NinjaGirlGmr/bluebot/3d_stl/README.md

# 3D STL Parts

This directory contains the robot's printable 3D part models (`.stl`).

## Files

- `Buck Mount.stl`
- `Camera deck.stl`
- `Camera Mount.stl`
- `Compute deck.stl`
- `IMU Box.stl`
- `Lidar Deck.stl`
- `Motor Deck.stl`
- `Power Switch Housing & Charge Port.stl`
- `Stand-offs.stl`
- `WIFI Mount.stl`

## Notes

- Open these files in your slicer/CAD tool to inspect orientation and scaling before printing.
- Keep part filenames stable to avoid breaking references in documentation and build notes.
