NinjaGirlGmr/bluebot/src/isaac_ros_occupancy_grid_localizer/maps/isaac_sim.png

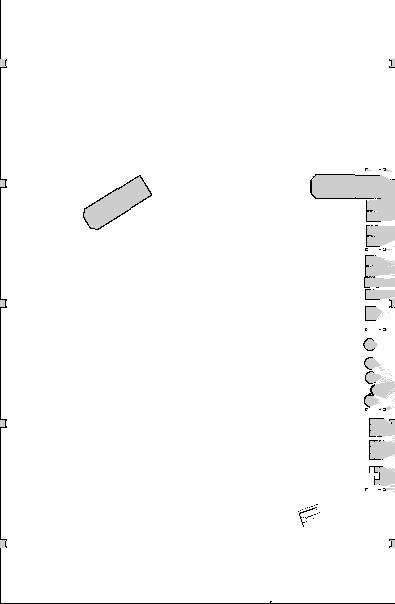
src/isaac_ros_occupancy_grid_localizer/maps/isaac_sim.png
