NinjaGirlGmr/bluebot/src/isaac_ros_occupancy_grid_localizer/maps/map.png

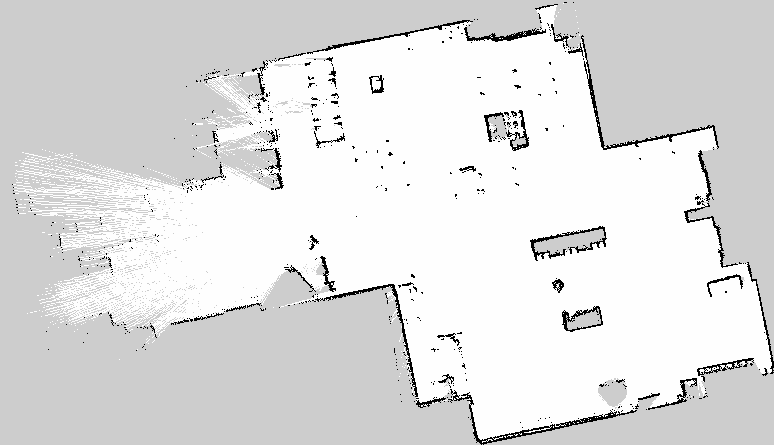
src/isaac_ros_occupancy_grid_localizer/maps/map.png
