NinjaGirlGmr/bluebot/3d_stl/Buck Mount.stl

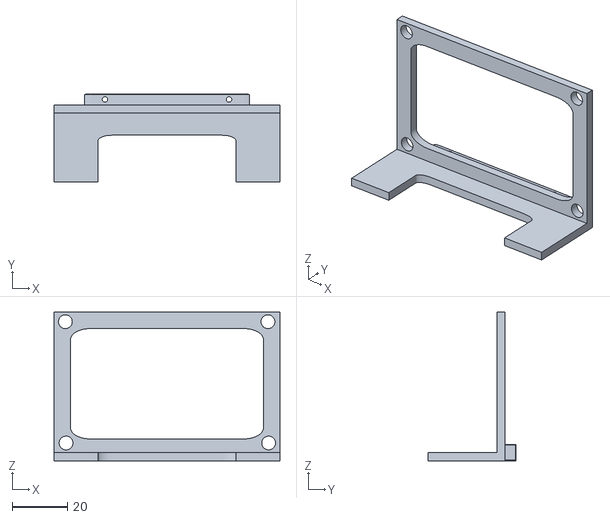
[picture p3: CAD file, 2026-03-10]
3d_stl/Buck Mount.stl
82.0 x 32.0 x 54.0
