NinjaGirlGmr/bluebot/3d_stl/Lidar Deck.stl

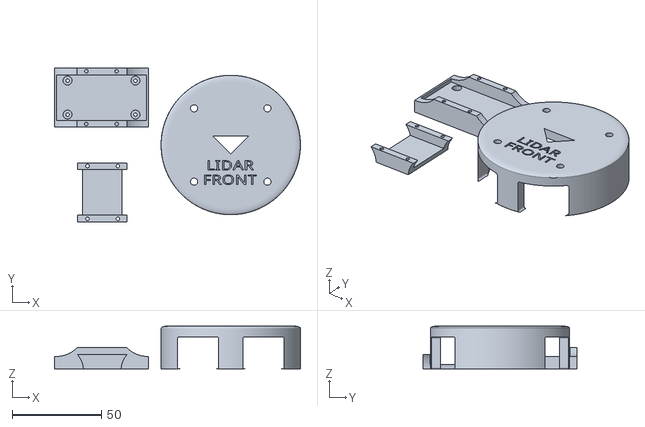
[picture p4: CAD file, 2026-03-10]
3d_stl/Lidar Deck.stl
137.6 x 86.0 x 24.0
