NinjaGirlGmr/bluebot/3d_stl/Camera Mount.stl

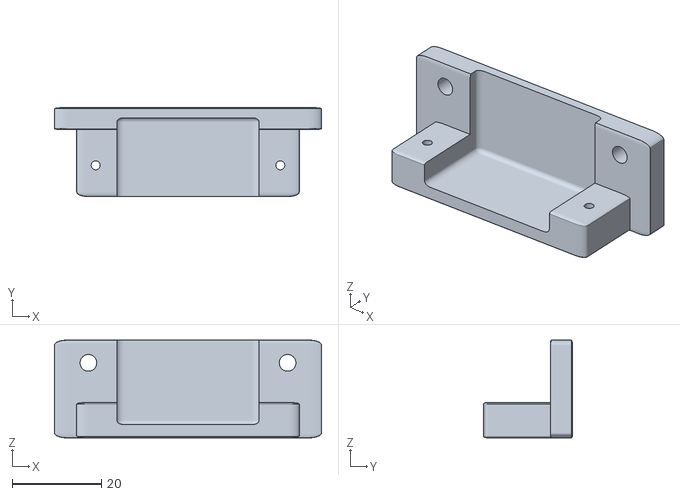
[picture p5: CAD file, 2026-03-10]
3d_stl/Camera Mount.stl
60.0 x 20.0 x 22.0
