NinjaGirlGmr/bluebot/3d_stl/Camera deck.stl

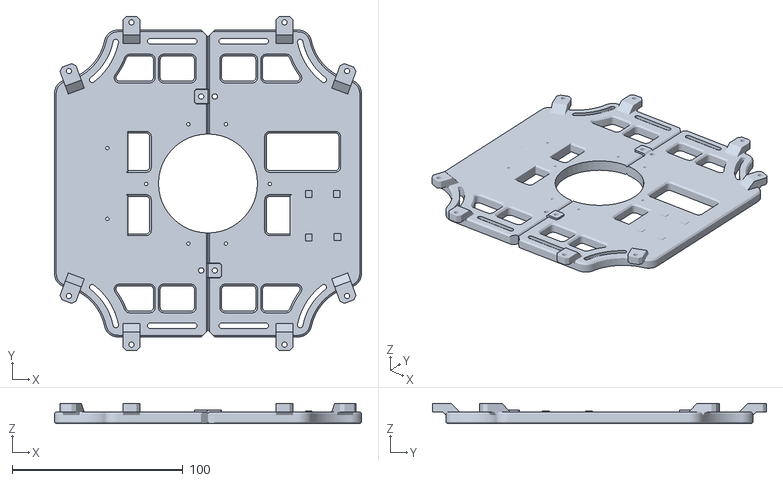
[picture p6: CAD file, 2026-03-10]
3d_stl/Camera deck.stl
180.0 x 196.0 x 12.0
