NinjaGirlGmr/bluebot/3d_stl/Stand-offs.stl

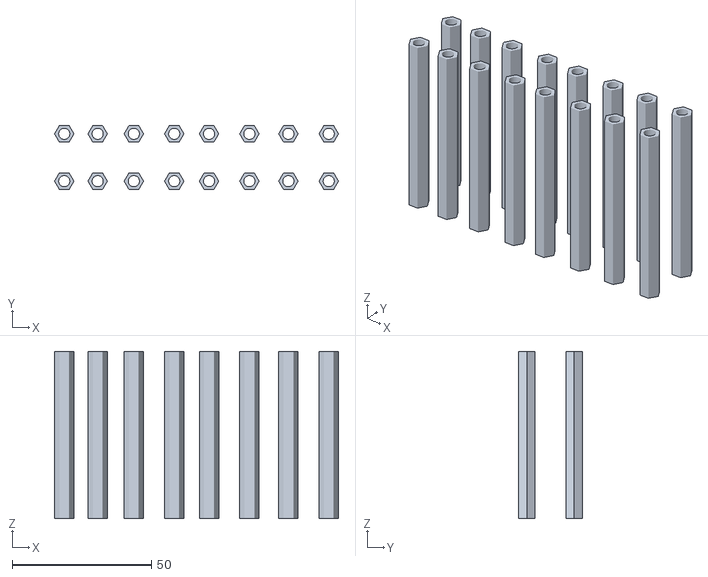
[picture p7: CAD file, 2026-03-10]
3d_stl/Stand-offs.stl
102.0 x 23.0 x 60.0
