NinjaGirlGmr/bluebot/3d_stl/Motor Deck.stl

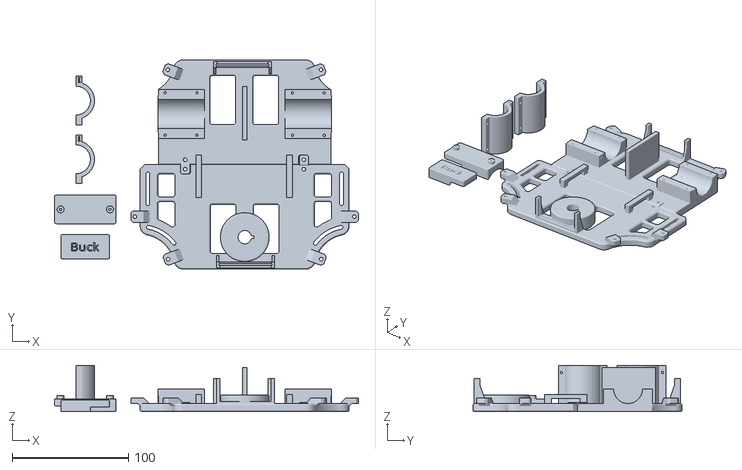
[picture p8: CAD file, 2026-03-10]
3d_stl/Motor Deck.stl
261.7 x 180.0 x 40.0
