NinjaGirlGmr/bluebot/3d_stl/Compute deck.stl

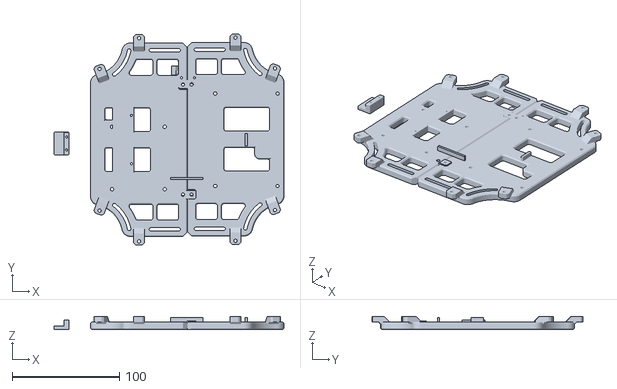
[picture p9: CAD file, 2026-03-10]
3d_stl/Compute deck.stl
214.0 x 196.5 x 12.0
