NinjaGirlGmr/bluebot/3d_stl/IMU Box.stl

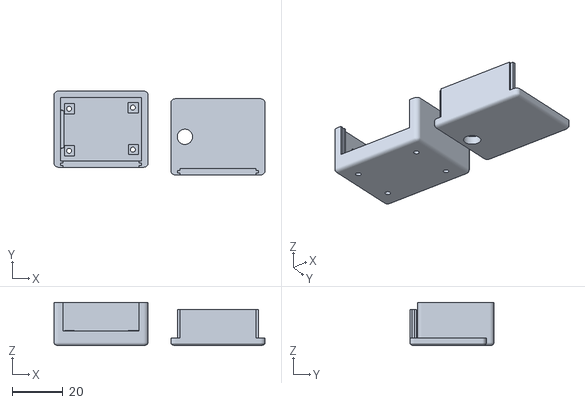
[picture p10: CAD file, 2026-03-10]
3d_stl/IMU Box.stl
83.0 x 33.0 x 17.0
