NinjaGirlGmr/bluebot/3d_stl/WIFI Mount.stl

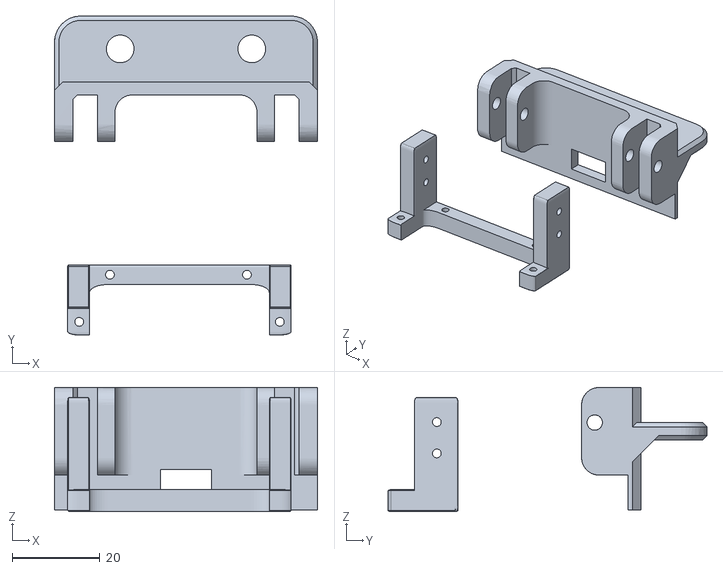
[picture p11: CAD file, 2026-03-10]
3d_stl/WIFI Mount.stl
60.0 x 72.8 x 28.3
