NinjaGirlGmr/bluebot/3d_stl/Power Switch Housing & Charge Port.stl

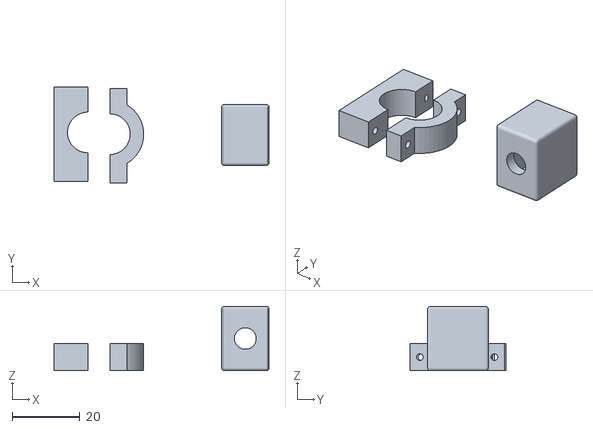
[picture p12: CAD file, 2026-03-10]
3d_stl/Power Switch Housing & Charge Port.stl
63.5 x 28.5 x 19.0
