NinjaGirlGmr/bluebot/src/robot_bringup/config/state_estimation_drift.yaml

robot_localization_filter:
  ros__parameters:
    use_sim_time: false
    frequency: 30.0
    sensor_timeout: 0.2
    two_d_mode: true
    debug: false
    publish_tf: true
    print_diagnostics: false
    use_control: false
    predict_to_current_time: true
    reset_on_time_jump: true
    transform_time_offset: 0.0
    transform_timeout: 0.0

    map_frame: map
    odom_frame: odom
    base_link_frame: base_link
    world_frame: odom

    # Primary pose source: wheel odometry.
    odom0: /odom_raw
    odom0_queue_size: 10
    odom0_differential: false
    odom0_relative: false
    odom0_config: [
      true, true, false,
      false, false, true,
      true, false, false,
      false, false, true,
      false, false, false
    ]

    # Keep imu0 channel wired but disabled by default.
    imu0: /imu/orientation
    imu0_queue_size: 10
    imu0_differential: false
    imu0_relative: false
    imu0_remove_gravitational_acceleration: false
    imu0_config: [
      false, false, false,
      false, false, false,
      false, false, false,
      false, false, false,
      false, false, false
    ]

    # Odom drift mitigation: use IMU yaw-rate only.
    imu1: /imu/data_raw
    imu1_queue_size: 10
    imu1_differential: false
    imu1_relative: false
    imu1_remove_gravitational_acceleration: true
    imu1_config: [
      false, false, false,
      false, false, false,
      false, false, false,
      false, false, true,
      false, false, false
    ]
