NinjaGirlGmr/bluebot/src/robot_bringup/robot_bringup/apriltag_map_recorder_node.py

#!/usr/bin/env python3

from dataclasses import dataclass
from pathlib import Path
import math
import re
from typing import Dict, Tuple

from geometry_msgs.msg import Pose, PoseArray, TransformStamped
from nav_msgs.msg import Odometry
import rclpy
from isaac_ros_apriltag_interfaces.msg import AprilTagDetectionArray
from rclpy.duration import Duration
from rclpy.executors import ExternalShutdownException
from rclpy.node import Node
from rclpy.qos import qos_profile_sensor_data
from rclpy.time import Time
from tf2_ros import Buffer, TransformBroadcaster, TransformException, TransformListener
import yaml


QuaternionTuple = Tuple[float, float, float, float]
Vector3Tuple = Tuple[float, float, float]


@dataclass
class TagAggregate:
    family: str
    tag_id: int
    observations: int = 0
    sum_x: float = 0.0
    sum_y: float = 0.0
    sum_z: float = 0.0
    sum_qx: float = 0.0
    sum_qy: float = 0.0
    sum_qz: float = 0.0
    sum_qw: float = 0.0
    latest_qx: float = 0.0
    latest_qy: float = 0.0
    latest_qz: float = 0.0
    latest_qw: float = 1.0
    first_seen_sec: float = 0.0
    last_seen_sec: float = 0.0
    last_sample_time_ns: int = 0


@dataclass
class TagTrackState:
    consecutive_count: int = 0
    last_seen_time_ns: int = 0


@dataclass
class TagLandmark:
    family: str
    tag_id: int
    observations: int
    first_seen_sec: float
    last_seen_sec: float
    x: float
    y: float
    z: float
    qx: float
    qy: float
    qz: float
    qw: float


class AprilTagMapRecorderNode(Node):
    def __init__(self) -> None:
        super().__init__('apriltag_map_recorder')

        self.declare_parameter('detections_topic', '/tag_detections')
        self.declare_parameter('odom_topic', '/odom')
        self.declare_parameter('map_frame', 'map')
        self.declare_parameter('output_yaml', '/tmp/apriltag_map_landmarks.yaml')
        self.declare_parameter('write_period_sec', 5.0)
        self.declare_parameter('min_observations', 1)
        self.declare_parameter('min_consecutive_detections', 10)
        self.declare_parameter('max_consecutive_gap_sec', 0.30)
        self.declare_parameter('min_sample_interval_sec', 0.10)
        self.declare_parameter('require_stationary', True)
        self.declare_parameter('max_robot_linear_speed_mps', 0.03)
        self.declare_parameter('max_robot_angular_speed_rad_s', 0.10)
        self.declare_parameter('min_detection_range_m', 0.10)
        self.declare_parameter('max_detection_range_m', 2.50)
        self.declare_parameter('use_covariance_filter', True)
        self.declare_parameter('allow_zero_covariance', True)
        self.declare_parameter('max_detection_position_stddev_m', 0.20)
        self.declare_parameter('max_detection_yaw_stddev_rad', 0.35)
        self.declare_parameter('use_latest_tf_on_failure', True)
        self.declare_parameter('write_on_shutdown', True)
        self.declare_parameter('log_new_tags', True)
        self.declare_parameter('log_rejections', False)
        self.declare_parameter('publish_landmarks_topic', True)
        self.declare_parameter('landmarks_topic', '/apriltag/landmarks')
        self.declare_parameter('publish_landmark_tf', True)
        self.declare_parameter('landmark_tf_child_frame_prefix', 'apriltag_landmark')
        self.declare_parameter('landmark_publish_period_sec', 0.50)

        self._detections_topic = str(self.get_parameter('detections_topic').value)
        self._odom_topic = str(self.get_parameter('odom_topic').value)
        self._map_frame = str(self.get_parameter('map_frame').value)
        self._output_yaml = str(self.get_parameter('output_yaml').value)
        self._write_period_sec = float(self.get_parameter('write_period_sec').value)
        self._min_observations = int(self.get_parameter('min_observations').value)
        self._min_consecutive_detections = int(
            self.get_parameter('min_consecutive_detections').value
        )
        self._max_consecutive_gap_sec = float(
            self.get_parameter('max_consecutive_gap_sec').value
        )
        self._min_sample_interval_sec = float(
            self.get_parameter('min_sample_interval_sec').value
        )
        self._require_stationary = bool(self.get_parameter('require_stationary').value)
        self._max_robot_linear_speed_mps = float(
            self.get_parameter('max_robot_linear_speed_mps').value
        )
        self._max_robot_angular_speed_rad_s = float(
            self.get_parameter('max_robot_angular_speed_rad_s').value
        )
        self._min_detection_range_m = float(self.get_parameter('min_detection_range_m').value)
        self._max_detection_range_m = float(self.get_parameter('max_detection_range_m').value)
        self._use_covariance_filter = bool(self.get_parameter('use_covariance_filter').value)
        self._allow_zero_covariance = bool(self.get_parameter('allow_zero_covariance').value)
        self._max_detection_position_stddev_m = float(
            self.get_parameter('max_detection_position_stddev_m').value
        )
        self._max_detection_yaw_stddev_rad = float(
            self.get_parameter('max_detection_yaw_stddev_rad').value
        )
        self._use_latest_tf_on_failure = bool(
            self.get_parameter('use_latest_tf_on_failure').value
        )
        self._write_on_shutdown = bool(self.get_parameter('write_on_shutdown').value)
        self._log_new_tags = bool(self.get_parameter('log_new_tags').value)
        self._log_rejections = bool(self.get_parameter('log_rejections').value)
        self._publish_landmarks_topic = bool(
            self.get_parameter('publish_landmarks_topic').value
        )
        self._landmarks_topic = str(self.get_parameter('landmarks_topic').value)
        self._publish_landmark_tf = bool(self.get_parameter('publish_landmark_tf').value)
        self._landmark_tf_child_frame_prefix = str(
            self.get_parameter('landmark_tf_child_frame_prefix').value
        ).strip('/')
        self._landmark_publish_period_sec = float(
            self.get_parameter('landmark_publish_period_sec').value
        )

        if self._write_period_sec <= 0.0:
            self._write_period_sec = 5.0
        if self._min_observations < 1:
            self._min_observations = 1
        if self._min_consecutive_detections < 1:
            self._min_consecutive_detections = 1
        if self._max_consecutive_gap_sec <= 0.0:
            self._max_consecutive_gap_sec = 0.30
        if self._min_sample_interval_sec < 0.0:
            self._min_sample_interval_sec = 0.0
        if self._max_robot_linear_speed_mps < 0.0:
            self._max_robot_linear_speed_mps = 0.0
        if self._max_robot_angular_speed_rad_s < 0.0:
            self._max_robot_angular_speed_rad_s = 0.0
        if self._min_detection_range_m < 0.0:
            self._min_detection_range_m = 0.0
        if self._max_detection_range_m < self._min_detection_range_m:
            self._max_detection_range_m = self._min_detection_range_m
        if self._max_detection_position_stddev_m <= 0.0:
            self._max_detection_position_stddev_m = 0.20
        if self._max_detection_yaw_stddev_rad <= 0.0:
            self._max_detection_yaw_stddev_rad = 0.35
        if self._landmark_publish_period_sec <= 0.0:
            self._landmark_publish_period_sec = 0.50

        self._tag_data: Dict[str, TagAggregate] = {}
        self._tag_track: Dict[str, TagTrackState] = {}
        self._dirty = False
        self._last_warn_ns: Dict[str, int] = {}
        self._have_odom = False
        self._last_linear_speed_mps = 0.0
        self._last_angular_speed_rad_s = 0.0

        self._max_consecutive_gap_ns = int(self._max_consecutive_gap_sec * 1.0e9)
        self._min_sample_interval_ns = int(self._min_sample_interval_sec * 1.0e9)

        self._tf_buffer = Buffer(cache_time=Duration(seconds=30.0))
        self._tf_listener = TransformListener(self._tf_buffer, self)
        self._landmarks_pub = None
        if self._publish_landmarks_topic:
            self._landmarks_pub = self.create_publisher(PoseArray, self._landmarks_topic, 10)
        self._landmark_tf_broadcaster = (
            TransformBroadcaster(self) if self._publish_landmark_tf else None
        )

        self.create_subscription(
            Odometry,
            self._odom_topic,
            self._on_odom,
            qos_profile_sensor_data,
        )
        self.create_subscription(
            AprilTagDetectionArray,
            self._detections_topic,
            self._on_detections,
            qos_profile_sensor_data,
        )
        self.create_timer(self._write_period_sec, self._on_write_timer)
        if self._landmarks_pub is not None or self._landmark_tf_broadcaster is not None:
            self.create_timer(
                self._landmark_publish_period_sec,
                self._on_landmarks_publish_timer,
            )

        self.get_logger().info(
            'AprilTag map recorder started. '
            f'detections_topic={self._detections_topic}, map_frame={self._map_frame}, '
            f'output_yaml={self._output_yaml}, require_stationary={self._require_stationary}, '
            f'min_consecutive={self._min_consecutive_detections}, '
            f'publish_landmarks_topic={self._publish_landmarks_topic}, '
            f'publish_landmark_tf={self._publish_landmark_tf}'
        )

    def _on_odom(self, msg: Odometry) -> None:
        twist = msg.twist.twist
        self._last_linear_speed_mps = math.sqrt(
            (twist.linear.x * twist.linear.x)
            + (twist.linear.y * twist.linear.y)
            + (twist.linear.z * twist.linear.z)
        )
        self._last_angular_speed_rad_s = abs(float(twist.angular.z))
        self._have_odom = True

    def _on_detections(self, msg: AprilTagDetectionArray) -> None:
        for detection in msg.detections:
            family = detection.family if detection.family else 'unknown'
            tag_id = int(detection.id)
            key = f'{family}:{tag_id}'

            source_frame = detection.pose.header.frame_id or msg.header.frame_id
            if not source_frame:
                self._warn_throttled(
                    'missing_source_frame',
                    'Skipping detection with empty source frame_id.',
                )
                continue

            pose_stamp = detection.pose.header.stamp
            if self._is_zero_stamp(pose_stamp):
                pose_stamp = msg.header.stamp
            stamp_time = self._stamp_to_time(pose_stamp)
            source_pose = detection.pose.pose.pose
            now_ns = (
                int(stamp_time.nanoseconds)
                if int(stamp_time.nanoseconds) != 0
                else self.get_clock().now().nanoseconds
            )

            detection_range_m = math.sqrt(
                (source_pose.position.x * source_pose.position.x)
                + (source_pose.position.y * source_pose.position.y)
                + (source_pose.position.z * source_pose.position.z)
            )
            if (
                detection_range_m < self._min_detection_range_m
                or detection_range_m > self._max_detection_range_m
            ):
                self._log_rejection(
                    key,
                    (
                        f'range gate failed ({detection_range_m:.2f}m outside '
                        f'[{self._min_detection_range_m:.2f}, {self._max_detection_range_m:.2f}]m)'
                    ),
                )
                self._update_track_state(key, now_ns)
                continue

            if self._use_covariance_filter and not self._covariance_ok(
                detection.pose.pose.covariance,
                key,
            ):
                self._update_track_state(key, now_ns)
                continue

            track_state = self._update_track_state(key, now_ns)
            if track_state.consecutive_count < self._min_consecutive_detections:
                continue

            if not self._is_stationary():
                self._log_rejection(
                    key,
                    (
                        f'robot moving (lin={self._last_linear_speed_mps:.3f} m/s, '
                        f'ang={self._last_angular_speed_rad_s:.3f} rad/s)'
                    ),
                )
                continue

            aggregate = self._tag_data.get(key)
            if aggregate is None:
                aggregate = TagAggregate(
                    family=family,
                    tag_id=tag_id,
                    first_seen_sec=self._now_sec(),
                )
                self._tag_data[key] = aggregate
                if self._log_new_tags:
                    self.get_logger().info(
                        f'New tag observed: family={aggregate.family}, id={aggregate.tag_id}'
                    )

            if (
                aggregate.last_sample_time_ns > 0
                and now_ns < aggregate.last_sample_time_ns + self._min_sample_interval_ns
            ):
                continue

            transformed = self._transform_pose_to_map(
                source_frame=source_frame,
                stamp_time=stamp_time,
                position=(
                    float(source_pose.position.x),
                    float(source_pose.position.y),
                    float(source_pose.position.z),
                ),
                orientation=(
                    float(source_pose.orientation.x),
                    float(source_pose.orientation.y),
                    float(source_pose.orientation.z),
                    float(source_pose.orientation.w),
                ),
            )

            if transformed is None:
                continue

            pos_map, quat_map = transformed
            now_sec = self._now_sec()
            quat_map = self._quat_normalize(quat_map)
            if aggregate.observations > 0:
                dot = self._quat_dot(
                    quat_map,
                    (
                        aggregate.sum_qx,
                        aggregate.sum_qy,
                        aggregate.sum_qz,
                        aggregate.sum_qw,
                    ),
                )
                if dot < 0.0:
                    quat_map = (-quat_map[0], -quat_map[1], -quat_map[2], -quat_map[3])

            aggregate.observations += 1
            aggregate.sum_x += pos_map[0]
            aggregate.sum_y += pos_map[1]
            aggregate.sum_z += pos_map[2]
            aggregate.sum_qx += quat_map[0]
            aggregate.sum_qy += quat_map[1]
            aggregate.sum_qz += quat_map[2]
            aggregate.sum_qw += quat_map[3]
            aggregate.latest_qx = quat_map[0]
            aggregate.latest_qy = quat_map[1]
            aggregate.latest_qz = quat_map[2]
            aggregate.latest_qw = quat_map[3]
            aggregate.last_seen_sec = now_sec
            aggregate.last_sample_time_ns = now_ns

            if aggregate.first_seen_sec <= 0.0:
                aggregate.first_seen_sec = now_sec

            self._dirty = True

    def _transform_pose_to_map(
        self,
        source_frame: str,
        stamp_time: Time,
        position: Vector3Tuple,
        orientation: QuaternionTuple,
    ) -> Tuple[Vector3Tuple, QuaternionTuple] | None:
        transform = None
        try:
            transform = self._tf_buffer.lookup_transform(
                self._map_frame,
                source_frame,
                stamp_time,
                timeout=Duration(seconds=0.05),
            )
        except TransformException as exc:
            if self._use_latest_tf_on_failure:
                try:
                    transform = self._tf_buffer.lookup_transform(
                        self._map_frame,
                        source_frame,
                        Time(),
                        timeout=Duration(seconds=0.05),
                    )
                except TransformException:
                    self._warn_throttled(
                        f'tf_lookup_latest_{source_frame}',
                        f'Failed transform {source_frame}->{self._map_frame}: {exc}',
                    )
                    return None
            else:
                self._warn_throttled(
                    f'tf_lookup_{source_frame}',
                    f'Failed transform {source_frame}->{self._map_frame}: {exc}',
                )
                return None

        tf_t = transform.transform.translation
        tf_q = transform.transform.rotation
        tf_translation: Vector3Tuple = (float(tf_t.x), float(tf_t.y), float(tf_t.z))
        tf_quaternion: QuaternionTuple = (
            float(tf_q.x),
            float(tf_q.y),
            float(tf_q.z),
            float(tf_q.w),
        )

        rotated_position = self._quat_rotate_vector(tf_quaternion, position)
        position_out: Vector3Tuple = (
            rotated_position[0] + tf_translation[0],
            rotated_position[1] + tf_translation[1],
            rotated_position[2] + tf_translation[2],
        )
        orientation_out = self._quat_normalize(
            self._quat_multiply(tf_quaternion, orientation)
        )
        return (position_out, orientation_out)

    def _on_write_timer(self) -> None:
        self.write_yaml_snapshot(force=False)

    def _on_landmarks_publish_timer(self) -> None:
        self._publish_registered_landmarks()

    def write_yaml_snapshot(self, force: bool) -> None:
        if not force and not self._dirty:
            return

        output_path = Path(self._output_yaml).expanduser()
        output_path.parent.mkdir(parents=True, exist_ok=True)

        landmarks = self._build_registered_landmarks()
        tags = []
        for item in landmarks:
            tags.append({
                'family': item.family,
                'id': item.tag_id,
                'observations': item.observations,
                'first_seen_sec': round(item.first_seen_sec, 6),
                'last_seen_sec': round(item.last_seen_sec, 6),
                'position': {
                    'x': round(item.x, 6),
                    'y': round(item.y, 6),
                    'z': round(item.z, 6),
                },
                'orientation': {
                    'x': round(item.qx, 6),
                    'y': round(item.qy, 6),
                    'z': round(item.qz, 6),
                    'w': round(item.qw, 6),
                },
            })

        payload = {
            'map_frame': self._map_frame,
            'generated_at_sec': round(self._now_sec(), 6),
            'detections_topic': self._detections_topic,
            'odom_topic': self._odom_topic,
            'min_observations': self._min_observations,
            'min_consecutive_detections': self._min_consecutive_detections,
            'require_stationary': self._require_stationary,
            'max_robot_linear_speed_mps': self._max_robot_linear_speed_mps,
            'max_robot_angular_speed_rad_s': self._max_robot_angular_speed_rad_s,
            'publish_landmarks_topic': self._publish_landmarks_topic,
            'landmarks_topic': self._landmarks_topic,
            'publish_landmark_tf': self._publish_landmark_tf,
            'landmark_tf_child_frame_prefix': self._landmark_tf_child_frame_prefix,
            'tags': tags,
        }

        try:
            with output_path.open('w', encoding='utf-8') as f:
                yaml.safe_dump(payload, f, sort_keys=False)
            self._dirty = False
            self.get_logger().info(
                f'Wrote {len(tags)} tag landmarks to {output_path}'
            )
        except OSError as exc:
            self.get_logger().error(f'Failed writing YAML to {output_path}: {exc}')

    def _sorted_tag_items(self) -> list[TagAggregate]:
        return sorted(
            self._tag_data.values(),
            key=lambda item: (item.family, item.tag_id),
        )

    def _build_registered_landmarks(self) -> list[TagLandmark]:
        landmarks: list[TagLandmark] = []
        for item in self._sorted_tag_items():
            if item.observations < self._min_observations:
                continue
            inv_count = 1.0 / float(item.observations)
            avg_q = self._quat_normalize(
                (item.sum_qx, item.sum_qy, item.sum_qz, item.sum_qw)
            )
            landmarks.append(
                TagLandmark(
                    family=item.family,
                    tag_id=item.tag_id,
                    observations=item.observations,
                    first_seen_sec=item.first_seen_sec,
                    last_seen_sec=item.last_seen_sec,
                    x=item.sum_x * inv_count,
                    y=item.sum_y * inv_count,
                    z=item.sum_z * inv_count,
                    qx=avg_q[0],
                    qy=avg_q[1],
                    qz=avg_q[2],
                    qw=avg_q[3],
                )
            )
        return landmarks

    def _publish_registered_landmarks(self) -> None:
        landmarks = self._build_registered_landmarks()
        now_msg = self.get_clock().now().to_msg()

        if self._landmarks_pub is not None:
            pose_array = PoseArray()
            pose_array.header.stamp = now_msg
            pose_array.header.frame_id = self._map_frame
            for landmark in landmarks:
                pose = Pose()
                pose.position.x = landmark.x
                pose.position.y = landmark.y
                pose.position.z = landmark.z
                pose.orientation.x = landmark.qx
                pose.orientation.y = landmark.qy
                pose.orientation.z = landmark.qz
                pose.orientation.w = landmark.qw
                pose_array.poses.append(pose)
            self._landmarks_pub.publish(pose_array)

        if self._landmark_tf_broadcaster is not None:
            tf_msgs: list[TransformStamped] = []
            for landmark in landmarks:
                tf_msg = TransformStamped()
                tf_msg.header.stamp = now_msg
                tf_msg.header.frame_id = self._map_frame
                tf_msg.child_frame_id = self._landmark_child_frame(
                    family=landmark.family,
                    tag_id=landmark.tag_id,
                )
                tf_msg.transform.translation.x = landmark.x
                tf_msg.transform.translation.y = landmark.y
                tf_msg.transform.translation.z = landmark.z
                tf_msg.transform.rotation.x = landmark.qx
                tf_msg.transform.rotation.y = landmark.qy
                tf_msg.transform.rotation.z = landmark.qz
                tf_msg.transform.rotation.w = landmark.qw
                tf_msgs.append(tf_msg)
            if tf_msgs:
                self._landmark_tf_broadcaster.sendTransform(tf_msgs)

    def _landmark_child_frame(self, family: str, tag_id: int) -> str:
        frame_suffix = self._sanitize_frame_component(f'{family}_{tag_id}')
        if not self._landmark_tf_child_frame_prefix:
            return frame_suffix
        return f'{self._landmark_tf_child_frame_prefix}/{frame_suffix}'

    @staticmethod
    def _sanitize_frame_component(raw: str) -> str:
        cleaned = re.sub(r'[^A-Za-z0-9_]+', '_', raw)
        cleaned = re.sub(r'_+', '_', cleaned).strip('_')
        return cleaned or 'tag'

    def _update_track_state(self, key: str, now_ns: int) -> TagTrackState:
        state = self._tag_track.get(key)
        if state is None:
            state = TagTrackState()
            self._tag_track[key] = state

        if state.last_seen_time_ns > 0 and now_ns <= (
            state.last_seen_time_ns + self._max_consecutive_gap_ns
        ):
            state.consecutive_count += 1
        else:
            state.consecutive_count = 1
        state.last_seen_time_ns = now_ns
        return state

    def _is_stationary(self) -> bool:
        if not self._require_stationary:
            return True
        if not self._have_odom:
            self._warn_throttled(
                'missing_odom',
                f'Waiting for odometry on "{self._odom_topic}" before recording tags.',
                period_sec=2.0,
            )
            return False
        return (
            self._last_linear_speed_mps <= self._max_robot_linear_speed_mps
            and self._last_angular_speed_rad_s <= self._max_robot_angular_speed_rad_s
        )

    def _covariance_ok(self, covariance, key: str) -> bool:
        if covariance is None or len(covariance) < 36:
            self._log_rejection(key, 'missing covariance array')
            return False

        var_x = float(covariance[0])
        var_y = float(covariance[7])
        var_yaw = float(covariance[35])

        if (
            abs(var_x) < 1.0e-12
            and abs(var_y) < 1.0e-12
            and abs(var_yaw) < 1.0e-12
        ):
            if self._allow_zero_covariance:
                return True
            self._log_rejection(key, 'zero covariance not allowed')
            return False

        if var_x < 0.0 or var_y < 0.0 or var_yaw < 0.0:
            self._log_rejection(key, 'negative covariance entries')
            return False

        pos_std = math.sqrt(max(var_x, var_y))
        yaw_std = math.sqrt(var_yaw)
        if pos_std > self._max_detection_position_stddev_m:
            self._log_rejection(
                key,
                (
                    f'position stddev too high ({pos_std:.3f}m > '
                    f'{self._max_detection_position_stddev_m:.3f}m)'
                ),
            )
            return False
        if yaw_std > self._max_detection_yaw_stddev_rad:
            self._log_rejection(
                key,
                (
                    f'yaw stddev too high ({yaw_std:.3f}rad > '
                    f'{self._max_detection_yaw_stddev_rad:.3f}rad)'
                ),
            )
            return False
        return True

    def _log_rejection(self, key: str, reason: str) -> None:
        if not self._log_rejections:
            return
        self._warn_throttled(f'reject_{key}', f'Rejected {key}: {reason}', period_sec=1.0)

    def _stamp_to_time(self, stamp_msg) -> Time:
        if self._is_zero_stamp(stamp_msg):
            return Time()
        return Time.from_msg(stamp_msg)

    @staticmethod
    def _is_zero_stamp(stamp_msg) -> bool:
        return int(stamp_msg.sec) == 0 and int(stamp_msg.nanosec) == 0

    def _now_sec(self) -> float:
        now = self.get_clock().now().nanoseconds
        return float(now) / 1.0e9

    def _warn_throttled(self, key: str, msg: str, period_sec: float = 5.0) -> None:
        now_ns = self.get_clock().now().nanoseconds
        prev_ns = self._last_warn_ns.get(key)
        if prev_ns is not None and now_ns < prev_ns + int(period_sec * 1.0e9):
            return
        self._last_warn_ns[key] = now_ns
        self.get_logger().warning(msg)

    @staticmethod
    def _quat_multiply(a: QuaternionTuple, b: QuaternionTuple) -> QuaternionTuple:
        ax, ay, az, aw = a
        bx, by, bz, bw = b
        return (
            (aw * bx) + (ax * bw) + (ay * bz) - (az * by),
            (aw * by) - (ax * bz) + (ay * bw) + (az * bx),
            (aw * bz) + (ax * by) - (ay * bx) + (az * bw),
            (aw * bw) - (ax * bx) - (ay * by) - (az * bz),
        )

    @staticmethod
    def _quat_conjugate(q: QuaternionTuple) -> QuaternionTuple:
        qx, qy, qz, qw = q
        return (-qx, -qy, -qz, qw)

    @classmethod
    def _quat_rotate_vector(cls, q: QuaternionTuple, v: Vector3Tuple) -> Vector3Tuple:
        vx, vy, vz = v
        v_quat: QuaternionTuple = (vx, vy, vz, 0.0)
        rotated = cls._quat_multiply(
            cls._quat_multiply(q, v_quat),
            cls._quat_conjugate(q),
        )
        return (rotated[0], rotated[1], rotated[2])

    @staticmethod
    def _quat_normalize(q: QuaternionTuple) -> QuaternionTuple:
        qx, qy, qz, qw = q
        norm = (qx * qx + qy * qy + qz * qz + qw * qw) ** 0.5
        if norm <= 1.0e-9:
            return (0.0, 0.0, 0.0, 1.0)
        inv_norm = 1.0 / norm
        return (qx * inv_norm, qy * inv_norm, qz * inv_norm, qw * inv_norm)

    @staticmethod
    def _quat_dot(a: QuaternionTuple, b: QuaternionTuple) -> float:
        return (a[0] * b[0]) + (a[1] * b[1]) + (a[2] * b[2]) + (a[3] * b[3])


def main(args=None) -> None:
    rclpy.init(args=args)
    node = None
    try:
        node = AprilTagMapRecorderNode()
        rclpy.spin(node)
    except (KeyboardInterrupt, ExternalShutdownException):
        pass
    finally:
        if node is not None:
            if node._write_on_shutdown:
                node.write_yaml_snapshot(force=True)
            node.destroy_node()
        if rclpy.ok():
            rclpy.shutdown()


if __name__ == '__main__':
    main()
