NinjaGirlGmr/bluebot/(commit log)

2026-03-08 Track bluebot workspace scripts, docs, and serial_diff_drive_hw package
    [my_robot.urdf, my_robot_parsed.urdf, robot_localization_ekf.yaml, serial_diff_drive_hw.urdf]
2026-03-10 slam_toolbox updates for basline
    [robot_localization_ekf.yaml]
2026-03-10 Update RViz odometry views and submodule refs
2026-03-10 add 3d stl files
2026-03-10 Add stl files
    [my_robot.urdf, my_robot_parsed.urdf]
2026-03-10 Update 3d_stl content
    [Buck Mount.stl, Camera deck.stl]
2026-03-10 Added STL files
    [Camera Mount.stl, Compute deck.stl, IMU Box.stl, Lidar Deck.stl, Motor Deck.stl, Power Switch Housing & Charge Port.stl, Stand-offs.stl, WIFI Mount.stl]
2026-03-10 Update README with hardware and setup information
    Added hardware and Jetson setup sections to README.
2026-03-10 Update ROS2 stack flow diagrams and styles
2026-03-10 Enhance flowchart with style definitions and sections
    Added style definitions and organized flowchart sections for better clarity.
2026-03-10 Refactor style definitions and update flowchart labels
2026-03-16 added Wifi switch
2026-03-16 Add wifi mode switch script with OLED + service support
2026-04-22 added wiring diagram
